ACSBEN/bitaxe-ACS/3d/TL3340AF160QG.step

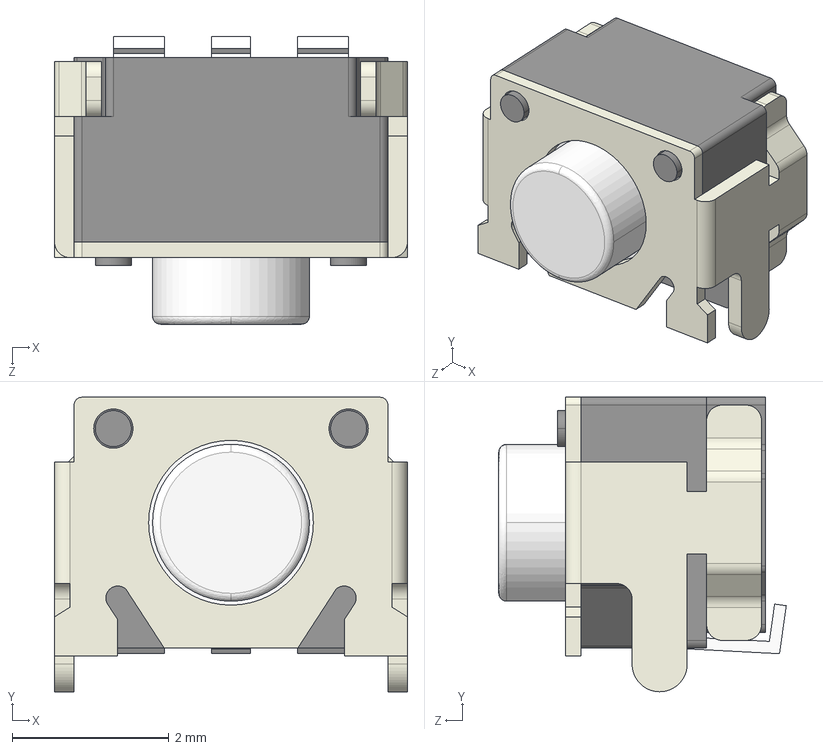
[picture p1: CAD file, 2024-11-26]
3d/TL3340AF160QG.step
4.50 x 3.76 x 3.67 mm
