ACSBEN/bitaxe-ACS/bitaxeUltra.kicad_pcb

## KiCad design bitaxeUltra.kicad_pcb (2024-11-26)

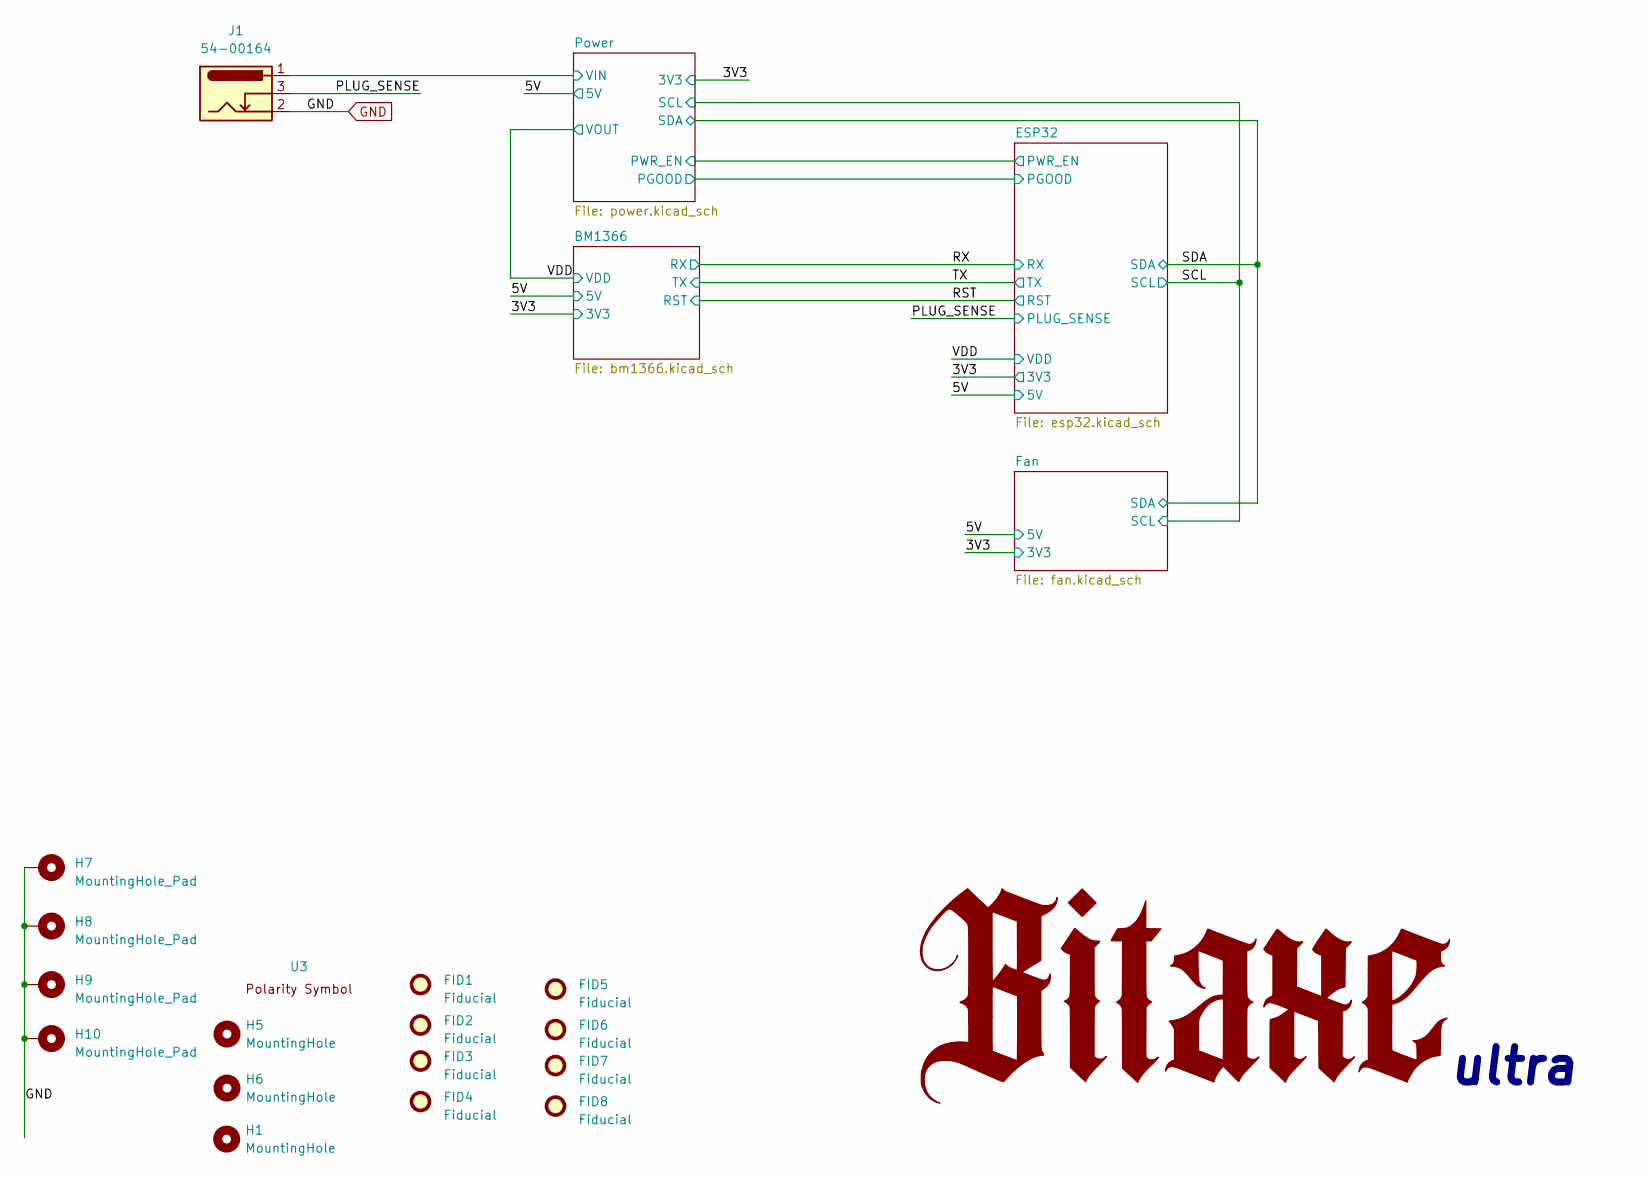
[picture p2: schematic bitaxeUltra.kicad_sch, BM1366 bitaxe]

Parts:
FID1, FID2, FID3, FID4, FID5, FID6, FID7, FID8: Fiducial; Fiducial_1mm_Mask2mm
H1, H5, H6: MountingHole; MountingHole_3.5mm
H7, H8, H9, H10: MountingHole_Pad; MountingHole_3mm_Pad_Via
J1: 54-00164; BarrelJack_Wuerth_694106106102_2.0x5.5mm; PARTNO 54-00164
U3: polarity

Connections:
/PLUG_SENSE: J1.3; also elsewhere on the board
/Power/VIN: J1.1; also elsewhere on the board
GND: H7.1, H8.1, H9.1, H10.1, J1.2; also elsewhere on the board

Notes on the sheet:
ultra

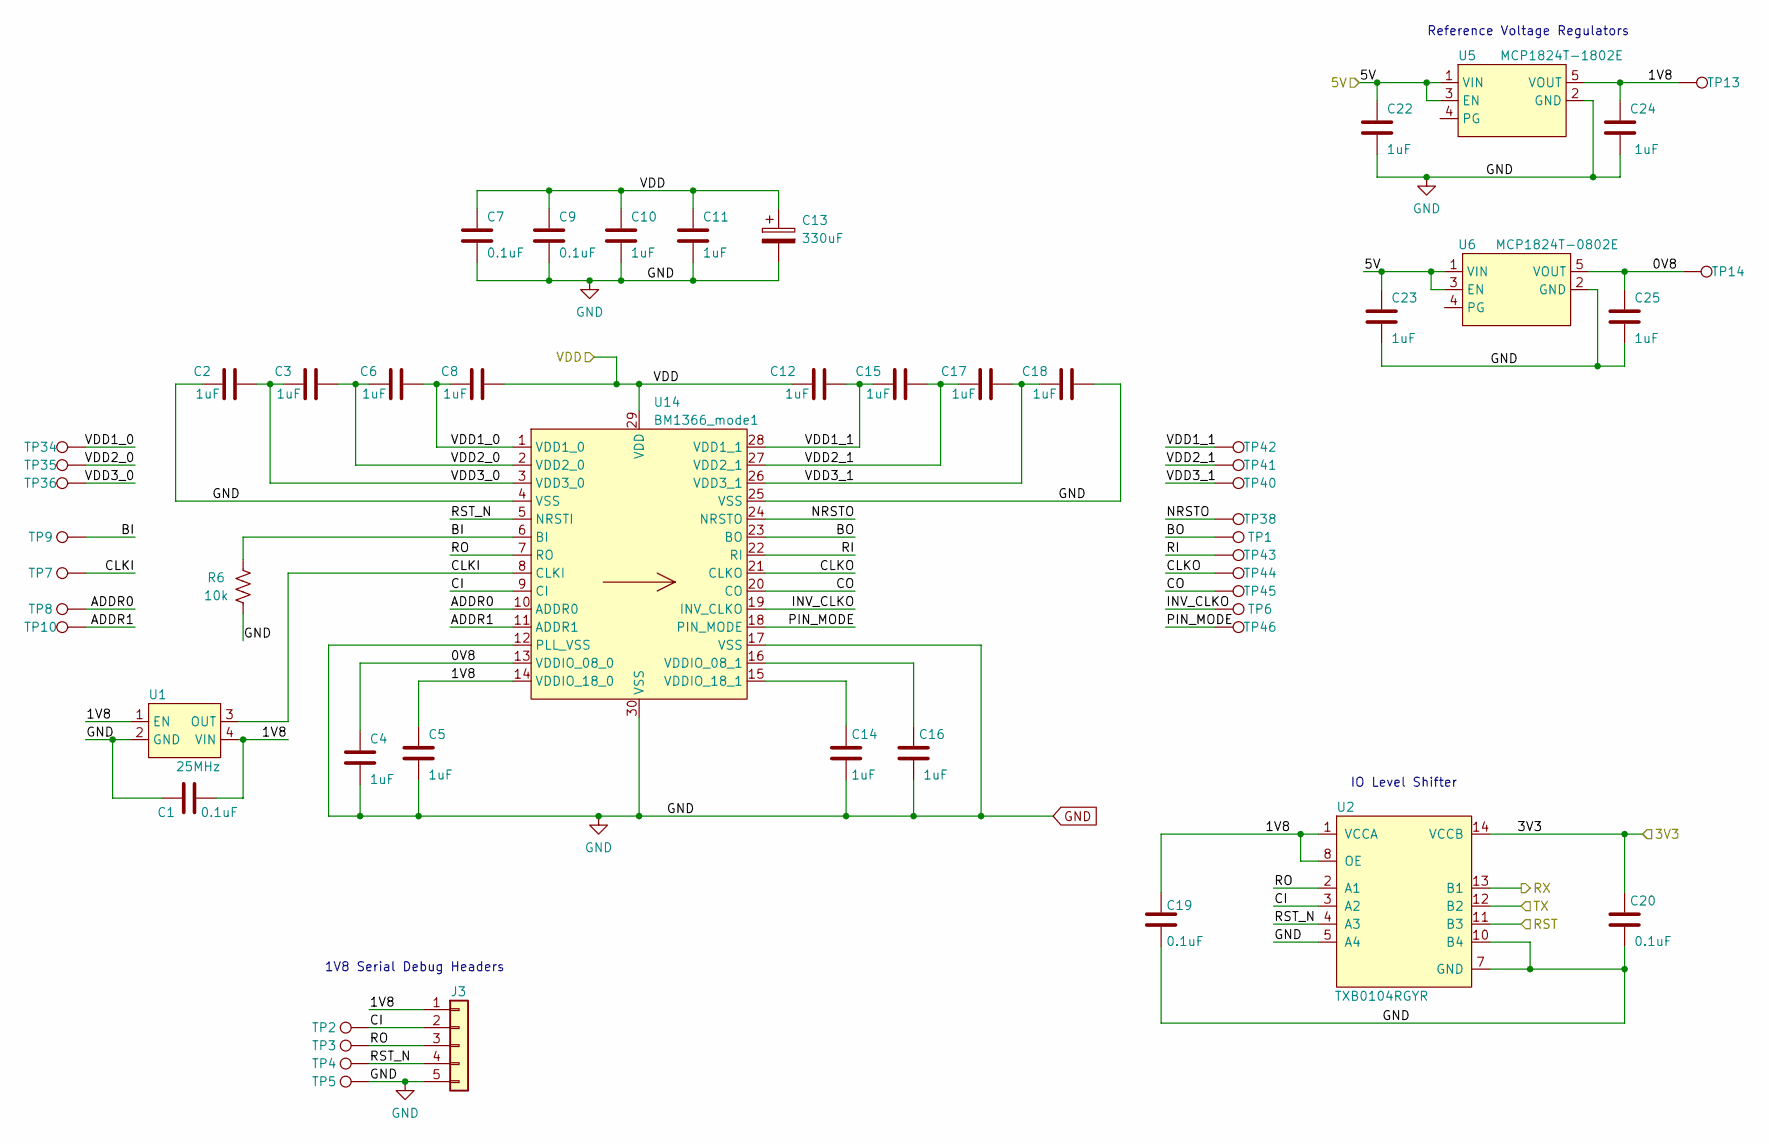
[picture p3: schematic bm1366.kicad_sch, BM1366 bitaxe]

Parts:
C1, C7, C9, C19, C20: 0.1uF; C_0402_1005Metric; PARTNO 0402X104K100CT
C2, C3, C4, C5, C6, C8, C10, C11, C12, C14, C15, C16, C17, C18, C22, C23, C24, C25: 1uF; C_0402_1005Metric; PARTNO EMK105BJ105MV-F
C13: 330uF; CP_EIA-7343-31_Kemet-D_Pad2.25x2.55mm_HandSolder; PARTNO 293D337X9010E2TE3
J3: Conn_01x05; PinHeader_1x05_P2.54mm_Vertical
R6: 10k; R_0402_1005Metric; PARTNO RC0402JR-0710KL
TP1, TP2, TP3, TP4, TP5, TP6, TP7, TP8, TP9, TP10, TP13, TP14, TP34, TP35, TP36, TP38, TP40, TP41, TP42, TP43, TP44, TP45, TP46: TestPoint; TestPoint_Pad_D1.5mm
U1: 25MHz; O 25,0-JO32-B-1V3-1-T1-LF; PARTNO O 25,0-JO32-B-1V3-1-T1-LF
U2: TXB0104RGYR; TXB0104; PARTNO TXB0104RGYR
U5: MCP1824T-1802E; SOT-23-5; PARTNO MCP1824T-1802E/OT
U6: MCP1824T-0802E; SOT-23-5; PARTNO MCP1824T-0802E/OT
U14: BM1366_mode1; BM1366

Connections:
/3V3: C20.1, U2.14 (VCCB); also elsewhere on the board
/5V: C22.1, C23.1, U5.1 (VIN), U5.3 (EN), U6.1 (VIN), U6.3 (EN); also elsewhere on the board
/BM1366/0V8: C4.1, C25.1, TP14.1, U6.5 (VOUT), U14.13 (VDDIO_08_0)
/BM1366/1V8: C1.2, C5.1, C19.1, C24.1, J3.1, TP13.1, U1.1 (EN), U1.4 (VIN), U2.1 (VCCA), U2.8 (OE), U5.5 (VOUT), U14.14 (VDDIO_18_0)
/BM1366/ADDR0: TP8.1, U14.10 (ADDR0)
/BM1366/ADDR1: TP10.1, U14.11 (ADDR1)
/BM1366/BI: R6.2, TP9.1, U14.6 (BI)
/BM1366/BO: TP1.1, U14.23 (BO)
/BM1366/CI: J3.2, TP2.1, U2.3 (A2), U14.9 (CI)
/BM1366/CLKI: TP7.1, U1.3 (OUT), U14.8 (CLKI)
/BM1366/CLKO: TP44.1, U14.21 (CLKO)
/BM1366/CO: TP45.1, U14.20 (CO)
/BM1366/INV_CLKO: TP6.1, U14.19 (INV_CLKO)
/BM1366/NRSTO: TP38.1, U14.24 (NRSTO)
/BM1366/PIN_MODE: TP46.1, U14.18 (PIN_MODE)
/BM1366/RI: TP43.1, U14.22 (RI)
/BM1366/RO: J3.3, TP3.1, U2.2 (A1), U14.7 (RO)
/BM1366/RST_N: J3.4, TP4.1, U2.4 (A3), U14.5 (NRSTI)
/BM1366/VDD1_0: C6.2, C8.1, TP34.1, U14.1 (VDD1_0)
/BM1366/VDD1_1: C12.2, C15.1, TP42.1, U14.28 (VDD1_1)
/BM1366/VDD2_0: C3.2, C6.1, TP35.1, U14.2 (VDD2_0)
/BM1366/VDD2_1: C15.2, C17.1, TP41.1, U14.27 (VDD2_1)
/BM1366/VDD3_0: C2.2, C3.1, TP36.1, U14.3 (VDD3_0)
/BM1366/VDD3_1: C17.2, C18.1, TP40.1, U14.26 (VDD3_1)
/RST: U2.11 (B3); also elsewhere on the board
/RX: U2.13 (B1); also elsewhere on the board
/TX: U2.12 (B2); also elsewhere on the board
/VDD: C7.1, C8.2, C9.1, C10.1, C11.1, C12.1, C13.1, U14.29 (VDD); also elsewhere on the board
GND: C1.1, C2.1, C4.2, C5.2, C7.2, C9.2, C10.2, C11.2, C13.2, C14.2, C16.2, C18.2, C19.2, C20.2, C22.2, C23.2, C24.2, C25.2, J3.5, R6.1, TP5.1, U1.2 (GND), U2.5 (A4), U2.7 (GND), U2.10 (B4), U2.15 (GND), U2.16 (GND), U2.17 (GND), U2.18 (GND), U2.19 (GND), U5.2 (GND), U6.2 (GND), U14.4 (VSS), U14.12 (PLL_VSS), U14.17 (VSS), U14.25 (VSS), U14.30 (VSS); also elsewhere on the board
unnamed: C16.1, U14.16 (VDDIO_08_1)
unnamed: C14.1, U14.15 (VDDIO_18_1)

Notes on the sheet:
1V8 Serial Debug Headers
Reference Voltage Regulators
IO Level Shifter

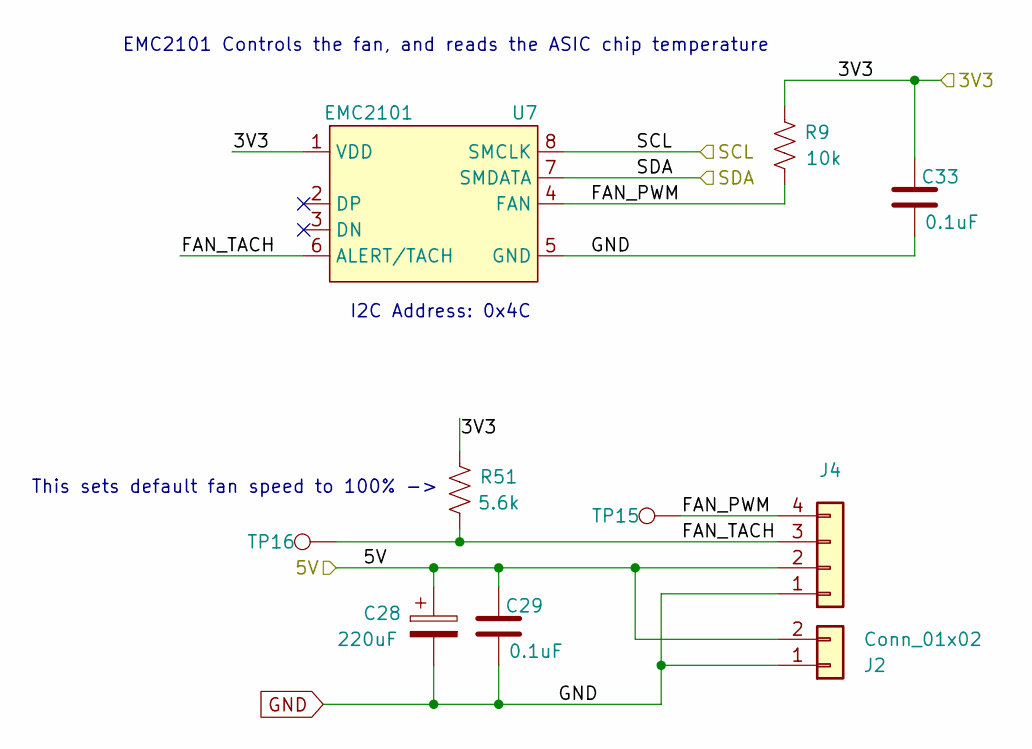
[picture p4: schematic fan.kicad_sch, BM1366 bitaxe]

Parts:
C28: 220uF; CP_Elec_6.3x7.7; PARTNO 865080345012
C29, C33: 0.1uF; C_0402_1005Metric; PARTNO 0402X104K100CT
J2: Conn_01x02; JST_XH_B2B-XH-A_1x02_P2.50mm_Vertical; PARTNO B2B-XH-A
J4: Conn_01x04; 470531000; PARTNO 0470531000
R9: 10k; R_0402_1005Metric; PARTNO RC0402JR-0710KL
R51: 5.6k; R_0402_1005Metric; PARTNO RC0402FR-135K6L
TP15, TP16: TestPoint; TestPoint_Pad_D1.5mm
U7: EMC2101; TSSOP-8_3x3mm_P0.65mm; PARTNO EMC2101-R-ACZL-TR

Connections:
/3V3: C33.1, R9.2, U7.1 (VDD); also elsewhere on the board
/5V: C28.1, C29.1, J2.2, J4.2; also elsewhere on the board
/Fan/FAN_PWM: J4.4, R9.1, TP15.1, U7.4 (FAN)
/Fan/FAN_TACH: J4.3, TP16.1, U7.6 (ALERT/TACH); also elsewhere on the board
/SCL: U7.8 (SMCLK); also elsewhere on the board
/SDA: U7.7 (SMDATA); also elsewhere on the board
GND: C28.2, C29.2, C33.2, J2.1, J4.1, U7.5 (GND); also elsewhere on the board

Notes on the sheet:
EMC2101 Controls the fan, and reads the ASIC chip temperature
This sets default fan speed to 100% ->
I2C Address: 0x4C

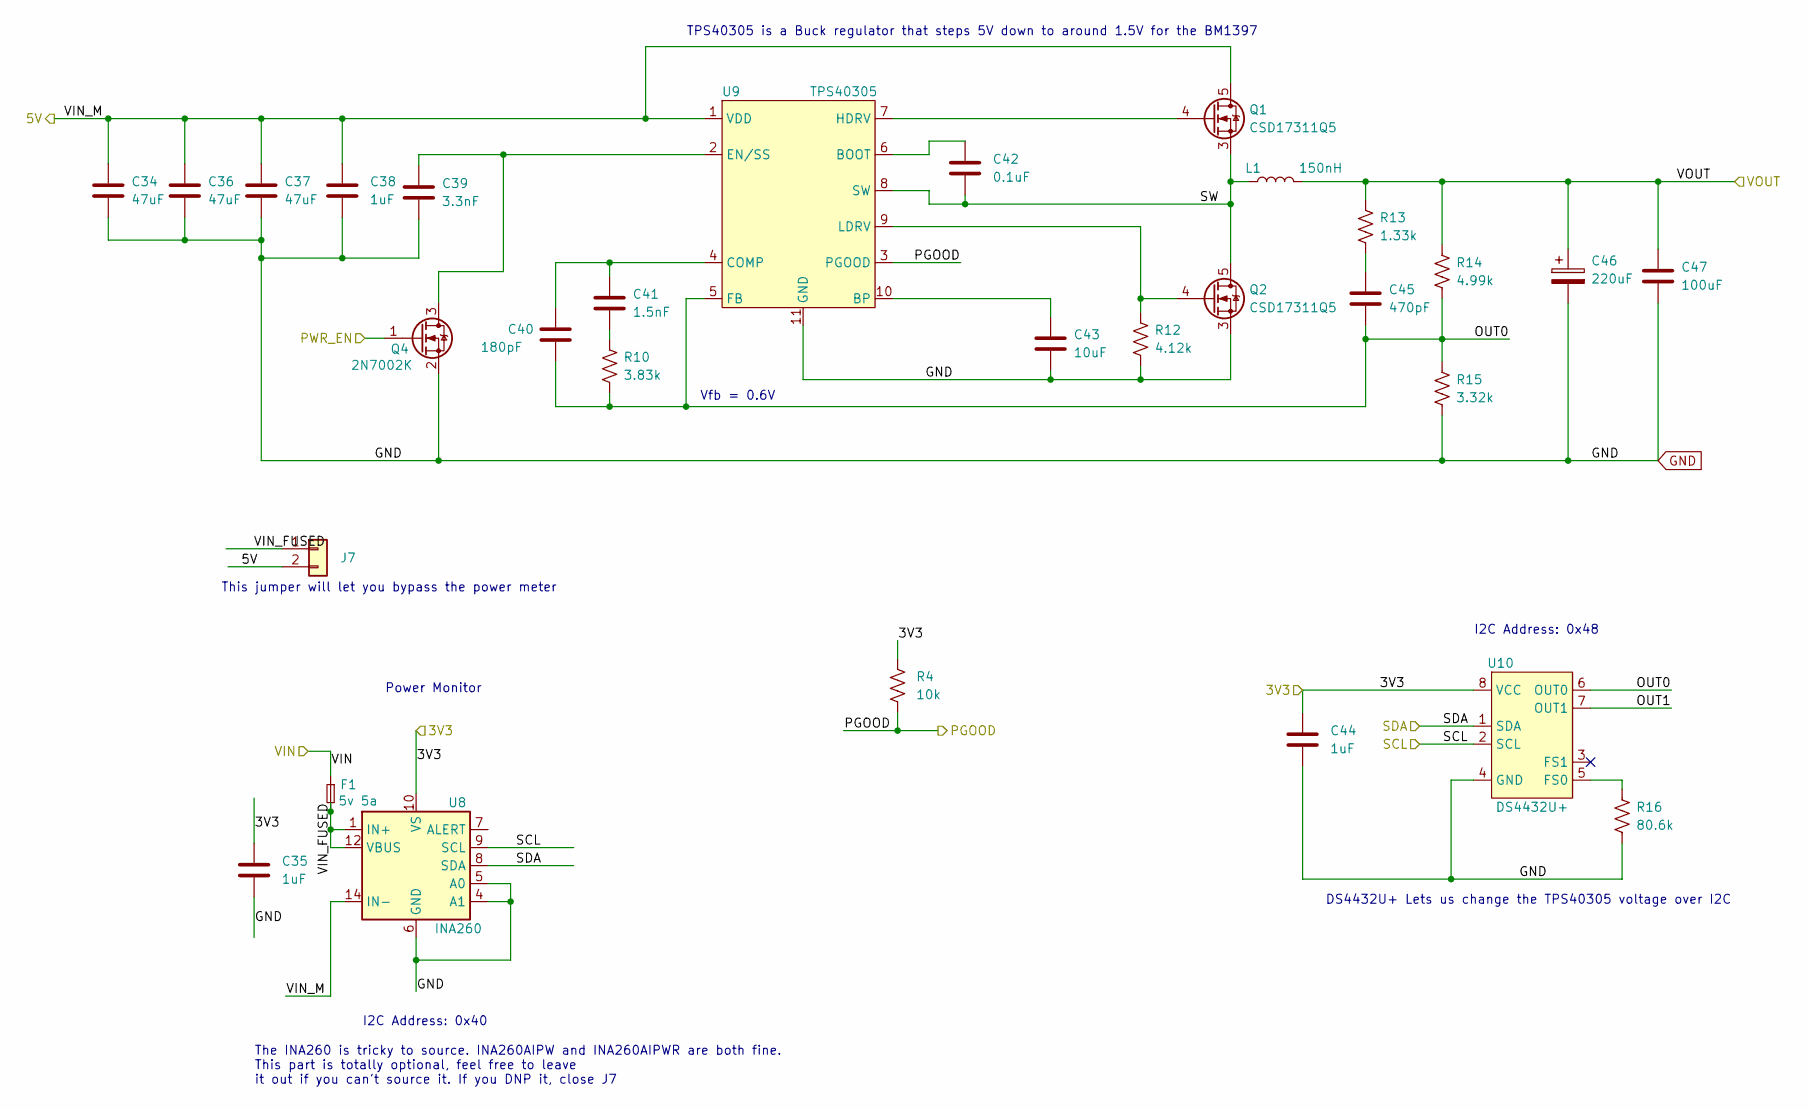
[picture p5: schematic power.kicad_sch, BM1366 bitaxe]

Parts:
C34, C36, C37: 47uF; C_1210_3225Metric; PARTNO GRM32ER61C476KE15L
C35, C44: 1uF; C_0402_1005Metric; PARTNO EMK105BJ105MV-F
C38: 1uF; C_0402_1005Metric; PARTNO CL21B105KOFNNNG
C39: 3.3nF; C_0402_1005Metric; PARTNO CL05B332KB5NNNC
C40: 180pF; C_0805_2012Metric; PARTNO CC0805JRNPO9BN181
C41: 1.5nF; C_0805_2012Metric; PARTNO CC0805KRX7R9BB152
C42: 0.1uF; C_0402_1005Metric; PARTNO 0402X104K100CT
C43: 10uF; C_0805_2012Metric; PARTNO CL21A106KOQNNNE
C45: 470pF; C_0805_2012Metric; PARTNO 0805B471K500CT
C46: 220uF; CAP_2R5TPE220MAFB; PARTNO 2R5TPE220MAFB
C47: 100uF; C_1206_3216Metric; PARTNO C3216X5R0J107M160AB
F1: 5v 5a; Fuse_0603_1608Metric
J7: Conn_01x02; PinHeader_1x02_P2.54mm_Vertical
L1: 150nH; FP1005R1-R15-R; PARTNO FP1005R1-R15-R
Q1, Q2: CSD17311Q5; PARTNO CSD17311Q5
Q4: 2N7002K; SOT-323_SC-70; PARTNO 2N7002KW
R4: 10k; R_0402_1005Metric; PARTNO RC0402JR-0710KL
R10: 3.83k; R_0402_1005Metric; PARTNO RC0402FR-073K83L
R12: 4.12k; R_0402_1005Metric; PARTNO RMCF0402FT4K12
R13: 1.33k; R_0402_1005Metric; PARTNO RC0402FR-071K33L
R14: 4.99k; R_0402_1005Metric; PARTNO RC0402FR-074K99L
R15: 3.32k; R_0402_1005Metric; PARTNO RC0402FR-073K32L
R16: 80.6k; R_0402_1005Metric; PARTNO RC0402FR-0780K6L
U8: INA260; TSSOP-16_4.4x5mm_P0.65mm; PARTNO INA260AIPW
U9: TPS40305; PARTNO TPS40305DRCR
U10: DS4432U+; TSSOP-8_3x3mm_P0.65mm; PARTNO DS4432U+

Connections:
/3V3: C35.1, C44.1, R4.1, U8.10 (VS), U10.8 (VCC); also elsewhere on the board
/5V: C34.1, C36.1, C37.1, C38.1, J7.2, Q1.5 (D), U8.14 (IN-), U8.15 (IN-), U8.16 (IN-), U9.1 (VDD); also elsewhere on the board
/ESP32/PWR_EN: Q4.1 (G); also elsewhere on the board
/Power/OUT0: C40.2, C45.2, R10.2, R14.2, R15.1, U9.5 (FB), U10.6 (OUT0)
/Power/OUT1: U10.7 (OUT1)
/Power/PGOOD: R4.2, U9.3 (PGOOD); also elsewhere on the board
/Power/SW: C42.2, L1.1, Q1.1, Q1.2, Q1.3 (S), Q2.5 (D), U9.8 (SW)
/Power/VIN: F1.1; also elsewhere on the board
/Power/VIN_FUSED: F1.2, J7.1, U8.1 (IN+), U8.2 (IN+), U8.3 (IN+), U8.12 (VBUS)
/SCL: U8.9 (SCL), U10.2 (SCL); also elsewhere on the board
/SDA: U8.8 (SDA), U10.1 (SDA); also elsewhere on the board
/VDD: C46.1, C47.1, L1.2, R13.1, R14.1; also elsewhere on the board
GND: C34.2, C35.2, C36.2, C37.2, C38.2, C39.2, C43.2, C44.2, C46.2, C47.2, Q2.1, Q2.2, Q2.3 (S), Q4.2 (S), R12.2, R15.2, R16.2, U8.4 (A1), U8.5 (A0), U8.6 (GND), U8.11 (GND), U9.11 (GND), U10.4 (GND); also elsewhere on the board
unnamed: C41.2, R10.1
unnamed: C45.1, R13.2
unnamed: Q1.4 (G), U9.7 (HDRV)
unnamed: Q2.4 (G), R12.1, U9.9 (LDRV)
unnamed: C39.1, Q4.3 (D), U9.2 (EN/SS)
unnamed: C42.1, U9.6 (BOOT)
unnamed: C43.1, U9.10 (BP)
unnamed: C40.1, C41.1, U9.4 (COMP)
unnamed: R16.1, U10.5 (FS0)

Notes on the sheet:
DS4432U+ Lets us change the TPS40305 voltage over I2C
I2C Address: 0x48
The INA260 is tricky to source. INA260AIPW and INA260AIPWR are both fine. This part is totally optional, feel free to leave it out if you can't source it. If you DNP it, close J7
Power Monitor
TPS40305 is a Buck regulator that steps 5V down to around 1.5V for the BM1397
I2C Address: 0x40
Vfb = 0.6V
This jumper will let you bypass the power meter

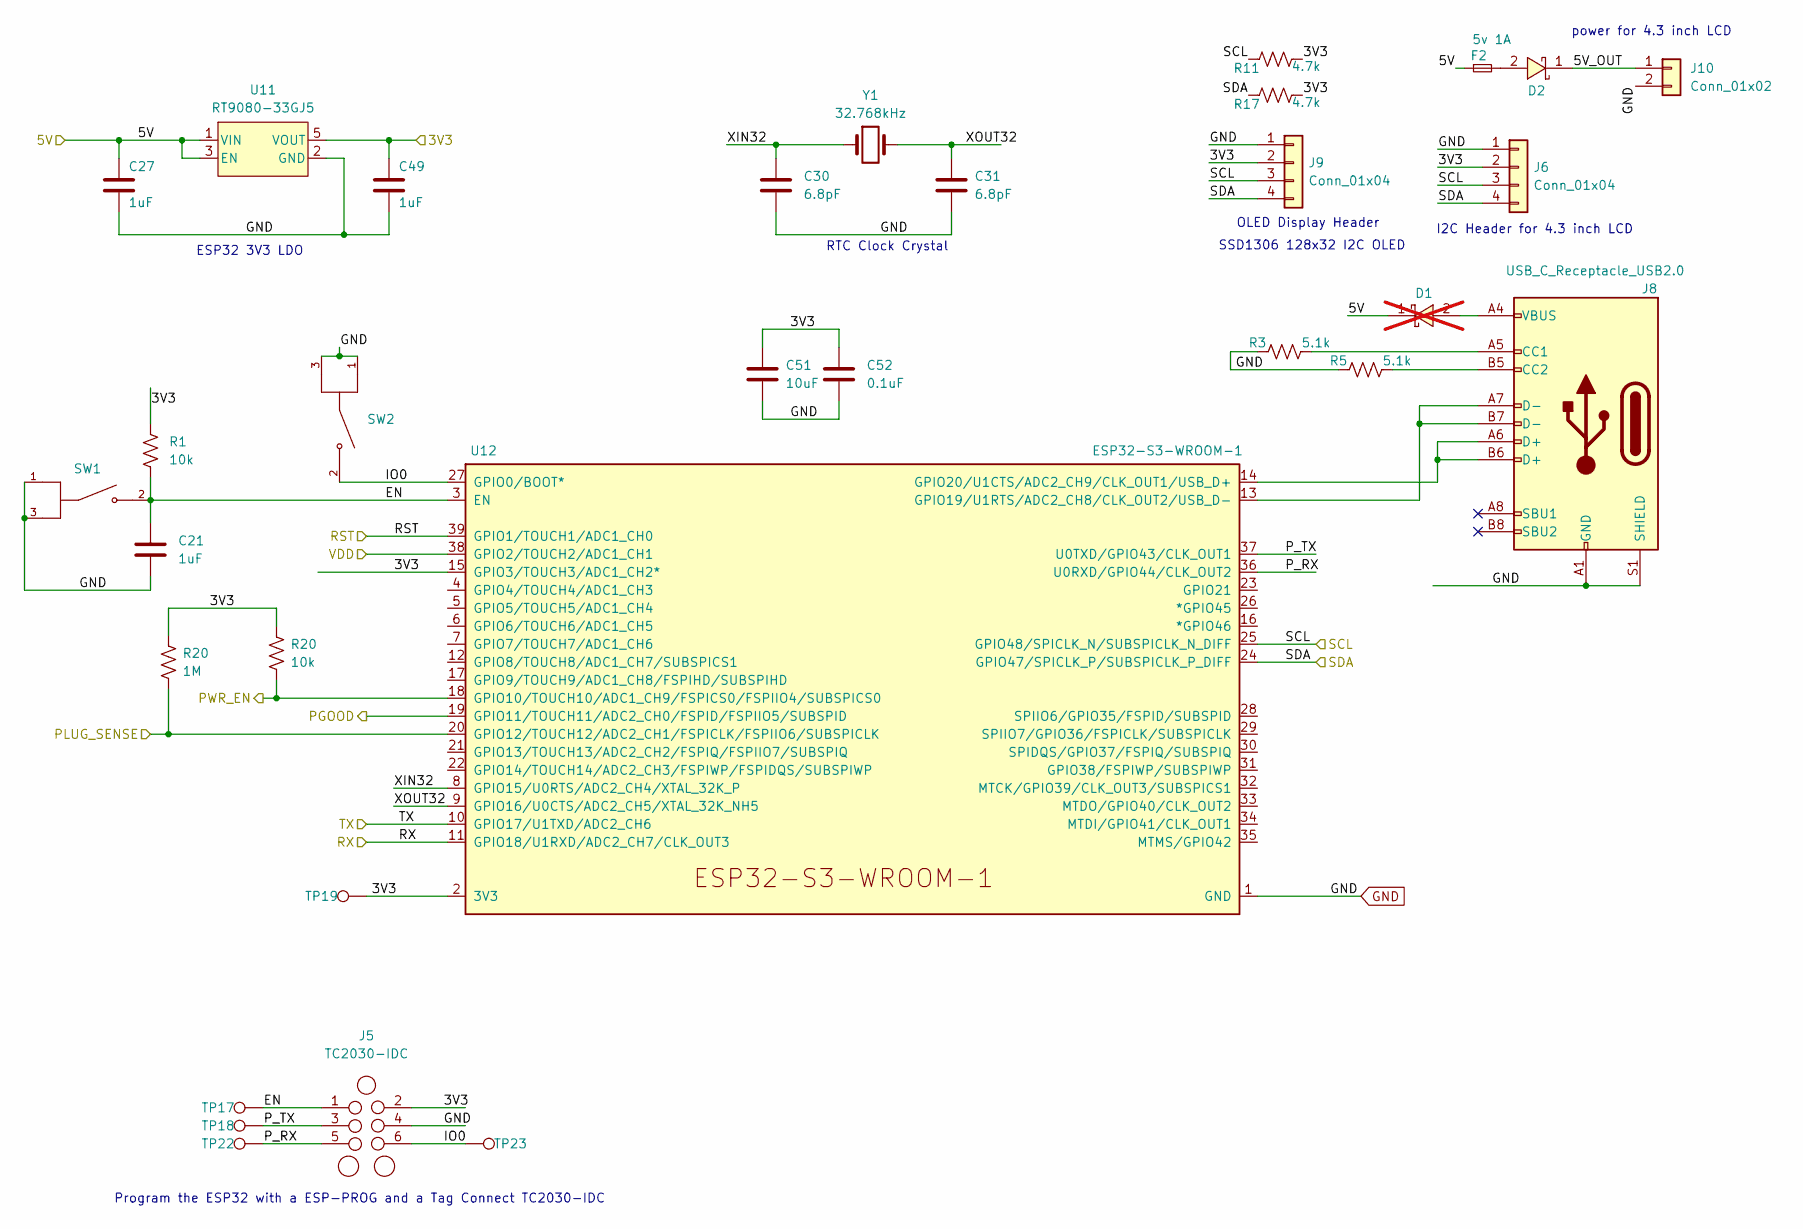
[picture p6: schematic esp32.kicad_sch, BM1366 bitaxe]

Parts:
C21, C27, C49: 1uF; C_0402_1005Metric; PARTNO EMK105BJ105MV-F
C30, C31: 6.8pF; C_0402_1005Metric; PARTNO C0402C689C5GAC7867
C51: 10uF; C_0805_2012Metric; PARTNO CL21A106KOQNNNE
C52: 0.1uF; C_0402_1005Metric; PARTNO 0402X104K100CT
D1: SS310; D_SMA; PARTNO SK310A-LTP; not fitted
D2: SS310; D_SMA; PARTNO SK310A-LTP
F2: 5v 1A; Fuse_0603_1608Metric
J5: TC2030-IDC; Tag-Connect_TC2030-IDC-NL_2x03_P1.27mm_Vertical
J6, J9: Conn_01x04; PinSocket_1x04_P2.54mm_Vertical
J8: USB_C_Receptacle_USB2.0; USB_C_Receptacle_GCT_USB4105-xx-A_16P_TopMnt_Horizontal; PARTNO USB4105-GF-A
J10: Conn_01x02; PinSocket_1x02_P2.54mm_Vertical
R1: 10k; R_0402_1005Metric; PARTNO RC0402JR-0710KL
R3, R5: 5.1k; R_0402_1005Metric; PARTNO RMCF0402JT5K10
R11, R17: 4.7k; R_0402_1005Metric; PARTNO RMCF0402JT5K10
R20: 1M; R_0402_1005Metric; PARTNO RC0402FR-071ML
SW1, SW2: GT-TC029B-H025-L1N; SW_TL3340AF160QG; PARTNO CS1213AGF260
TP17, TP18, TP19, TP22, TP23: TestPoint; TestPoint_Pad_D1.5mm
U11: RT9080-33GJ5; PARTNO RT9080-33GJ5
U12: ESP32-S3-WROOM-1; PARTNO ESP32-S3-WROOM-1-N16R8
Y1: 32.768kHz; SC32S-7PF20PPM; PARTNO SC32S-7PF20PPM

Connections:
/3V3: C49.1, C51.1, C52.1, J5.2, J6.2, J9.2, R1.1, R11.2, R17.2, TP19.1, U11.5 (VOUT), U12.2 (3V3), U12.15 (GPIO3/TOUCH3/ADC1_CH2*); also elsewhere on the board
/5V: C27.1, D1.1, F2.1, U11.1 (VIN), U11.3 (EN); also elsewhere on the board
/ESP32/5V_OUT: D2.1, J10.1
/ESP32/EN: C21.1, J5.1, R1.2, SW1.2, TP17.1, U12.3 (EN)
/ESP32/IO0: J5.6, SW2.2, TP23.1, U12.27 (GPIO0/BOOT*)
/ESP32/PWR_EN: U12.18 (GPIO10/TOUCH10/ADC1_CH9/FSPICS0/FSPIIO4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); also elsewhere on the board
/ESP32/P_RX: J5.5, TP22.1, U12.36 (U0RXD/GPIO44/CLK_OUT2)
/ESP32/P_TX: J5.3, TP18.1, U12.37 (U0TXD/GPIO43/CLK_OUT1)
/ESP32/XIN32: C30.1, U12.8 (GPIO15/U0RTS/ADC2_CH4/XTAL_32K_P), Y1.1
/ESP32/XOUT32: C31.1, U12.9 (GPIO16/U0CTS/ADC2_CH5/XTAL_32K_NH5), Y1.2
/PLUG_SENSE: U12.20 (GPIO12/TOUCH12/ADC2_CH1/FSPICLK/FSPIIO6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); also elsewhere on the board
/Power/PGOOD: U12.19 (GPIO11/TOUCH11/ADC2_CH0/FSPID/FSPIIO5/S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); also elsewhere on the board
/RST: U12.39 (GPIO1/TOUCH1/ADC1_CH0); also elsewhere on the board
/RX: U12.11 (GPIO18/U1RXD/ADC2_CH7/CLK_OUT3); also elsewhere on the board
/SCL: J6.3, J9.3, R11.1, U12.25 (GPIO48/SPICLK_N/SUBSPICLK_N_DIFF); also elsewhere on the board
/SDA: J6.4, J9.4, R17.1, U12.24 (GPIO47/SPICLK_P/SUBSPICLK_P_DIFF); also elsewhere on the board
/TX: U12.10 (GPIO17/U1TXD/ADC2_CH6); also elsewhere on the board
/VDD: U12.38 (GPIO2/TOUCH2/ADC1_CH1); also elsewhere on the board
GND: C21.2, C27.2, C30.2, C31.2, C49.2, C51.2, C52.2, J5.4, J6.1, J8.A1 (GND), J8.A12 (GND), J8.B1 (GND), J8.B12 (GND), J8.S1 (SHIELD), J9.1, J10.2, R3.1, R5.1, SW1.1, SW1.3, SW2.1, SW2.3, U11.2 (GND), U12.1 (GND), U12.40 (GND), U12.41 (GND); also elsewhere on the board
unnamed: D1.2, J8.A4 (VBUS), J8.A9 (VBUS), J8.B4 (VBUS), J8.B9 (VBUS)
unnamed: D2.2, F2.2
unnamed: J8.A5 (CC1), R3.2
unnamed: J8.B5 (CC2), R5.2
unnamed: J8.A7 (D-), J8.B7 (D-), U12.13 (GPIO19/U1RTS/ADC2_CH8/CLK_OUT2/USB_D-)
unnamed: J8.A6 (D+), J8.B6 (D+), U12.14 (GPIO20/U1CTS/ADC2_CH9/CLK_OUT1/USB_D+)

Notes on the sheet:
I2C Header for 4.3 inch LCD
RTC Clock Crystal
ESP32 3V3 LDO
Program the ESP32 with a ESP-PROG and a Tag Connect TC2030-IDC
SSD1306 128x32 I2C OLED
power for 4.3 inch LCD
OLED Display Header

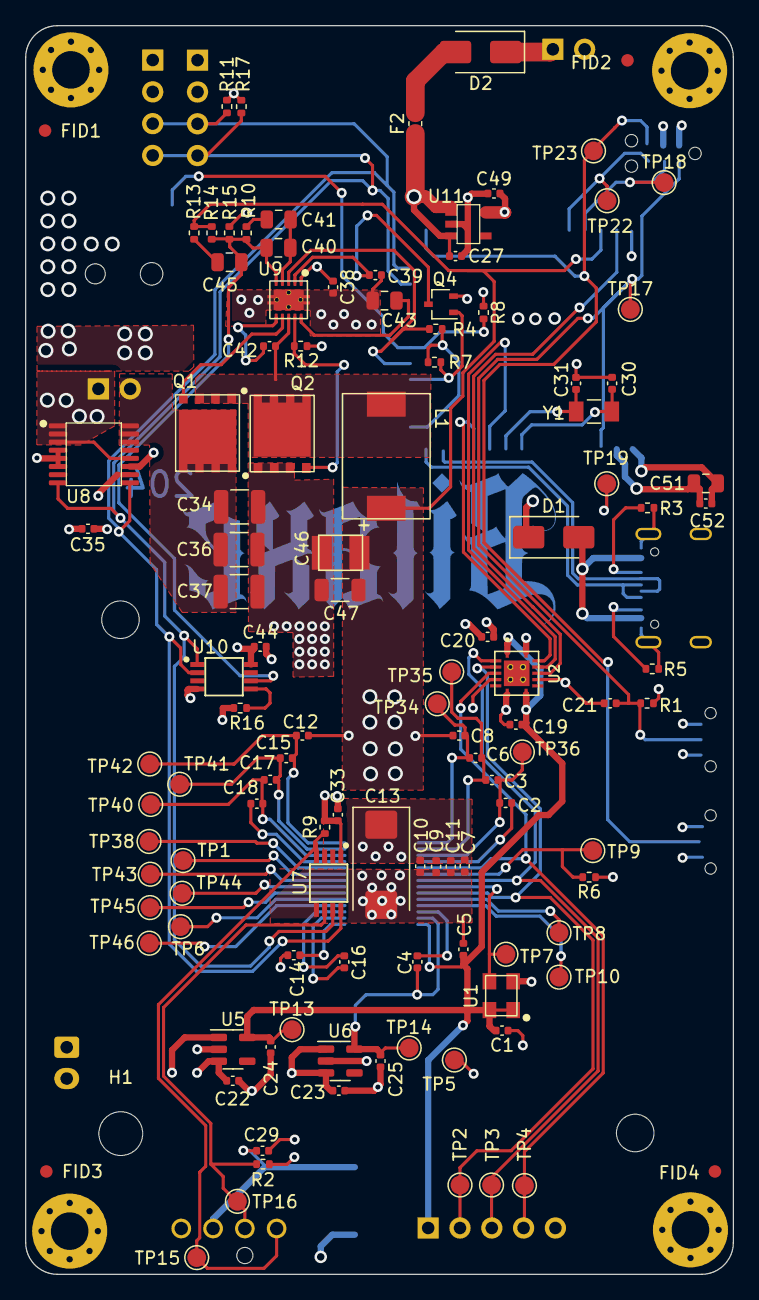
[picture p7: board bitaxeUltra.kicad_pcb from above]

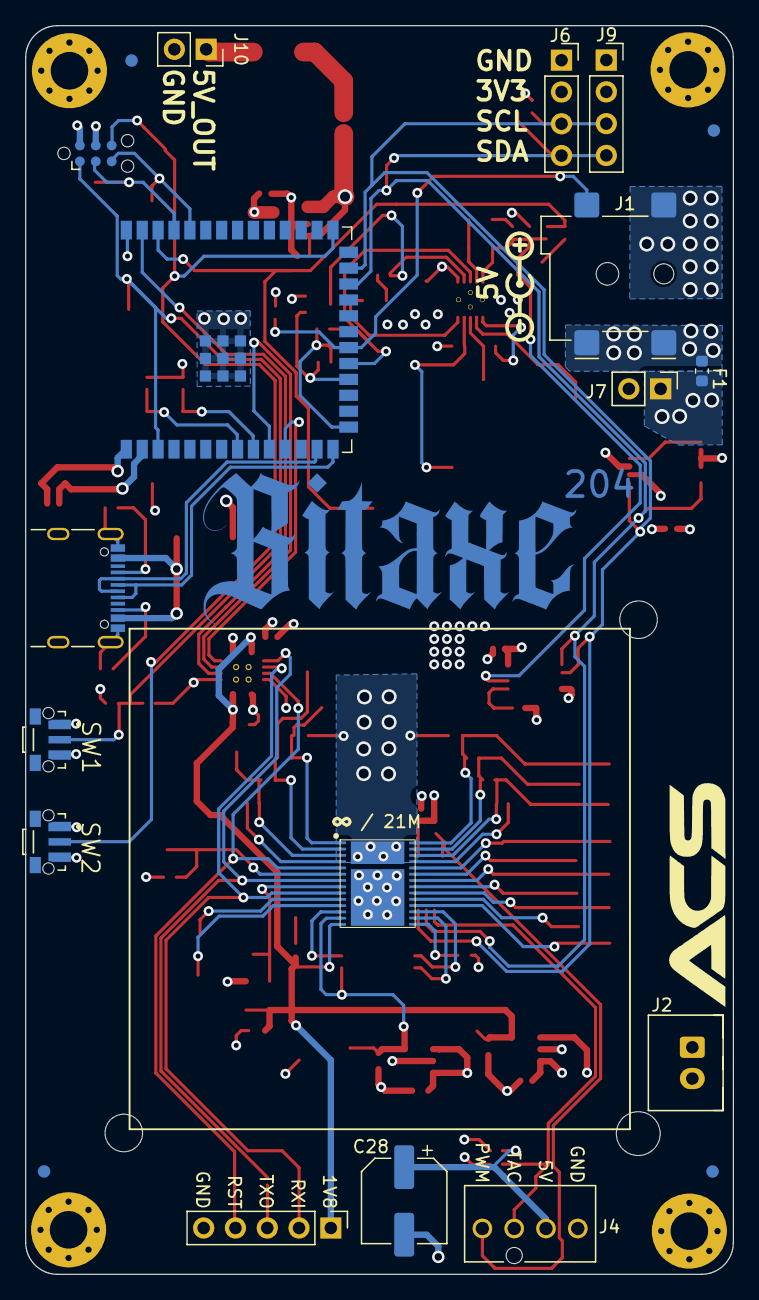
[picture p8: board bitaxeUltra.kicad_pcb from below]

Board: 4 copper layers, 56.5 x 99.8 mm, 143 parts (21 on the bottom side), 64 nets.

Other parts of the board:
R2: 5.6k; R_0402_1005Metric
R7: 10k; R_0402_1005Metric
R8: 1M; R_0402_1005Metric

Their connections:
/3V3: R2.2, R7.1, R8.1; also elsewhere on the board
/ESP32/PWR_EN: R7.2; also elsewhere on the board
/Fan/FAN_TACH: R2.1; also elsewhere on the board
/PLUG_SENSE: R8.2; also elsewhere on the board
