ACSBEN/bitaxe-ACS/(commit log)

2024-11-26 added new i2c connector, power connector, and supporting components
    [bitaxeUltra.kicad_sch, bm1366.kicad_sch, esp32.kicad_sch, fan.kicad_sch, power.kicad_sch]
2024-11-26 added 90 degree buttons
    [TL3340AF160QG.step]
2024-11-26 fixing DRC
    [bitaxeUltra.kicad_pcb]
2024-11-26 added 3rs heatsink mounting hole
    [bitaxeUltra.kicad_pcb]
2024-11-26 added sda and scl puulups
    [bitaxeUltra.kicad_pcb, bitaxeUltra.kicad_sch, esp32.kicad_sch, power.kicad_sch]
2024-11-26 small tweak
    [bitaxeUltra.kicad_pcb]
2024-11-26 added gerbers
    [bitaxeUltra-B_Cu.gbl, bitaxeUltra-B_Mask.gbs, bitaxeUltra-B_Paste.gbp, bitaxeUltra-B_Silkscreen.gbo, bitaxeUltra-Edge_Cuts.gm1, bitaxeUltra-F_Cu.gtl, bitaxeUltra-F_Mask.gts, bitaxeUltra-F_Paste.gtp]
2024-11-26 more BOMS
    [ACS Bitaxe Ultra Rev 1 JLC BOM - Front Side Only.csv, bom.csv, designators.csv, positions.csv]
